atomicra1n/desk-annunciator-panel/images/labels.png

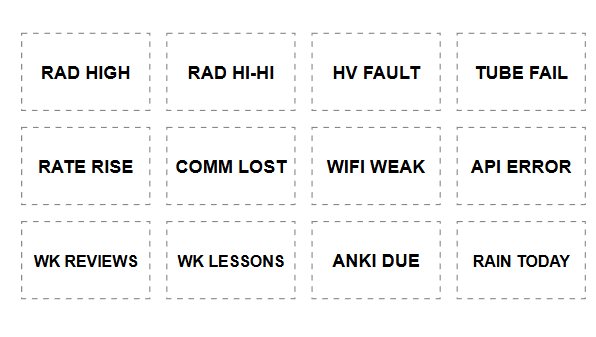
images/labels.png
