atomicra1n/desk-annunciator-panel/images/pcb.png

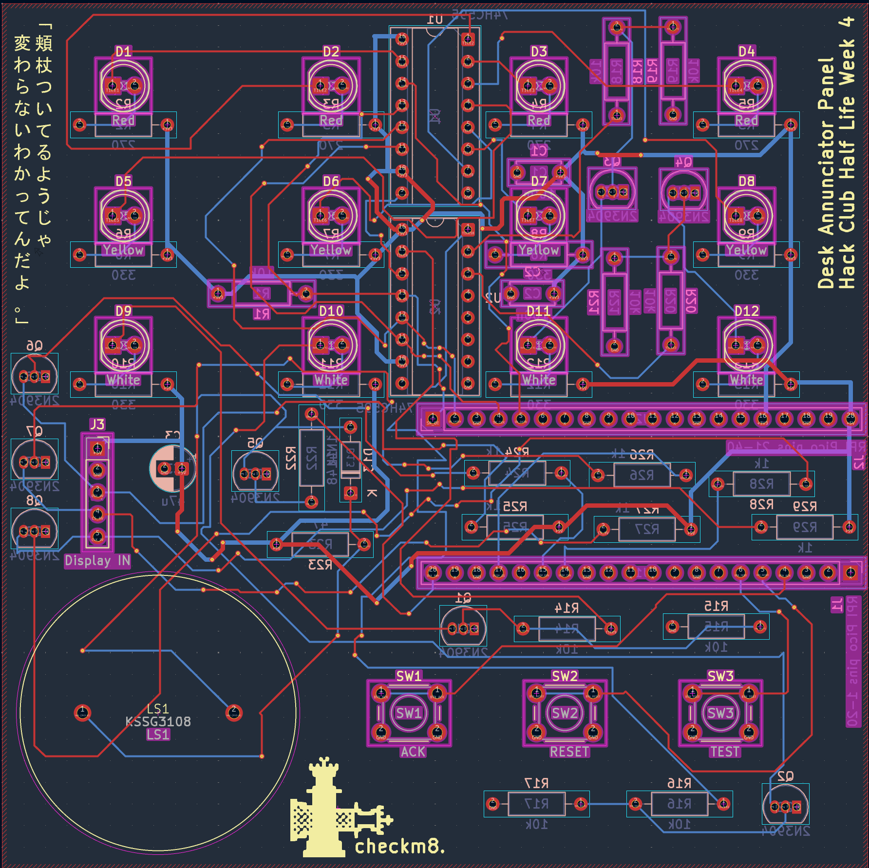
images/pcb.png
