atomicra1n/desk-annunciator-panel/images/pcb_back.png

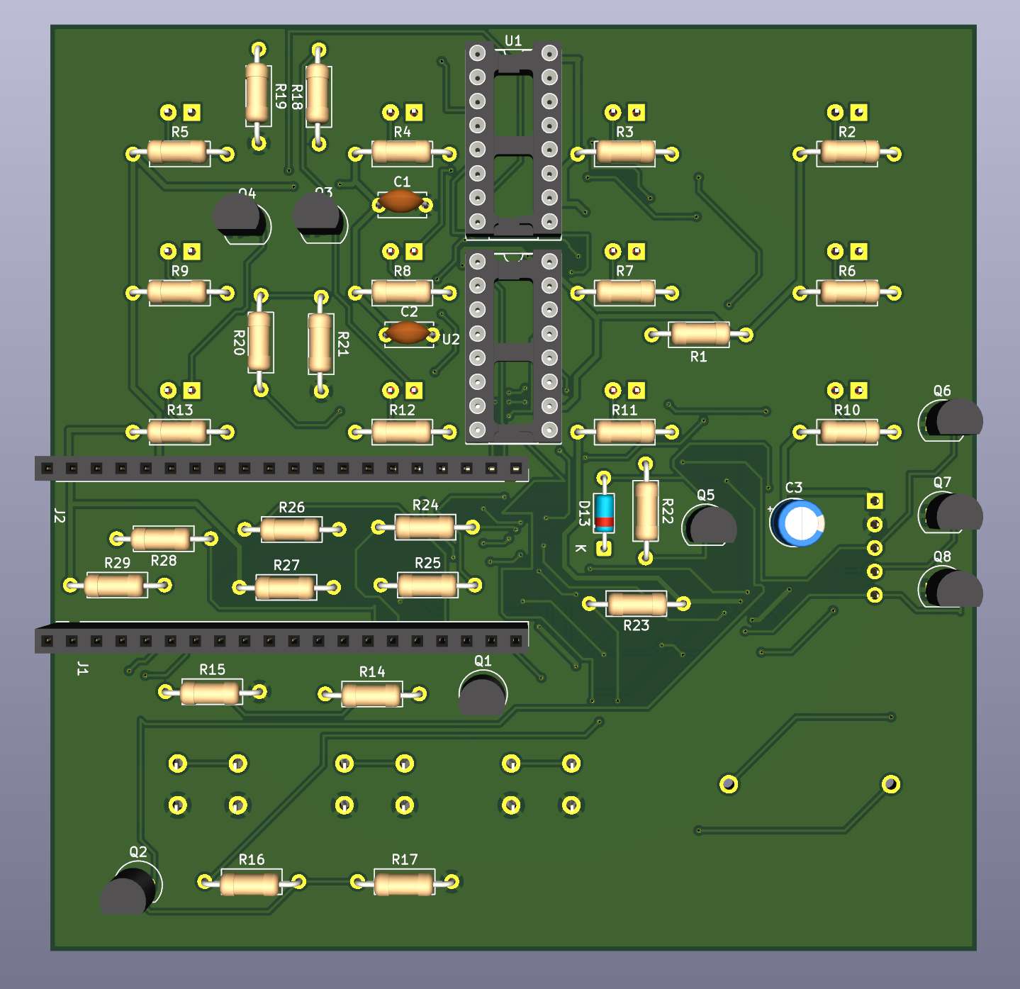
images/pcb_back.png
