atomicra1n/desk-annunciator-panel/images/pcb_front.png

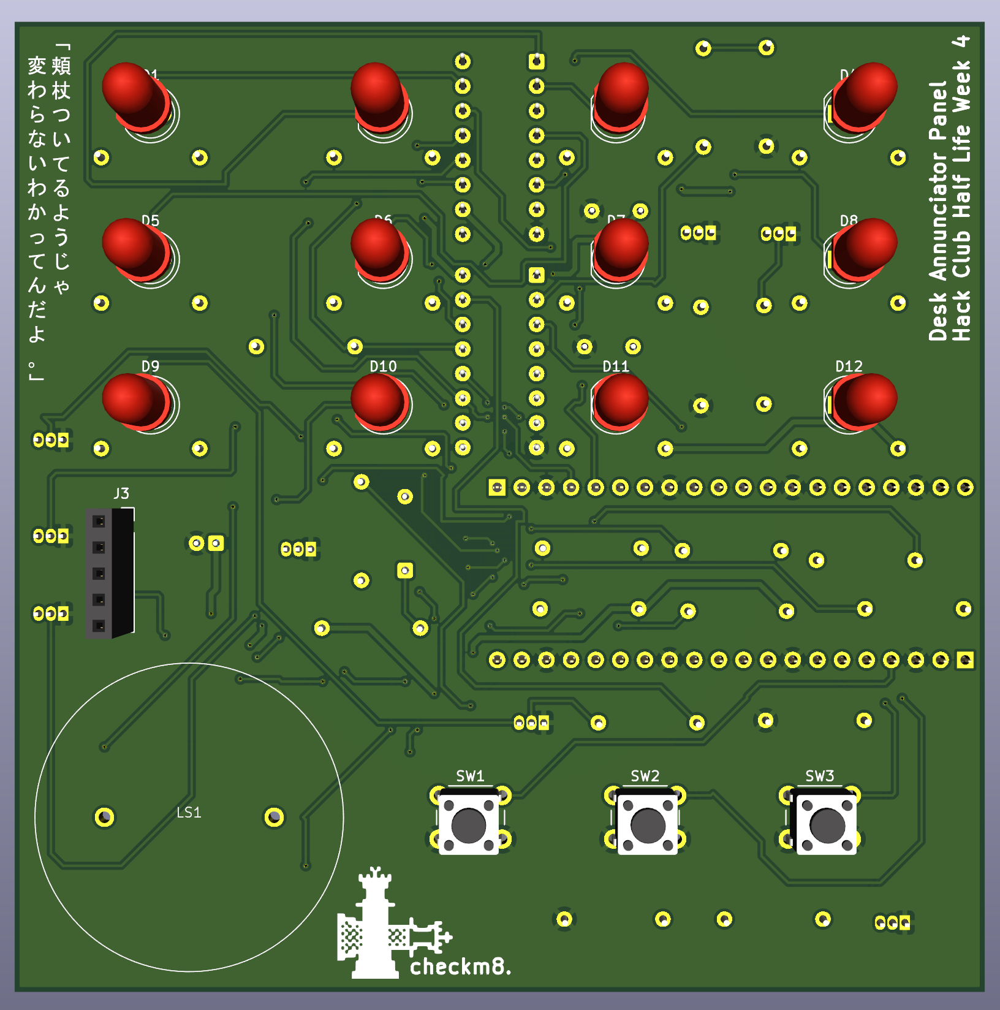
images/pcb_front.png
