atomicra1n/desk-annunciator-panel/images/render.png

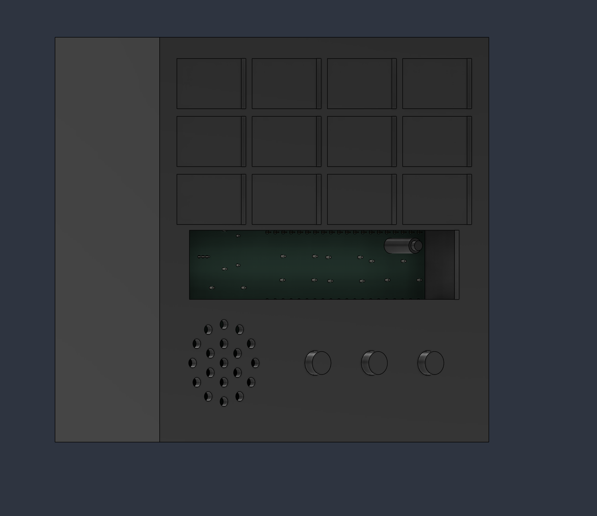
images/render.png
