atomicra1n/desk-annunciator-panel/images/schematic.png

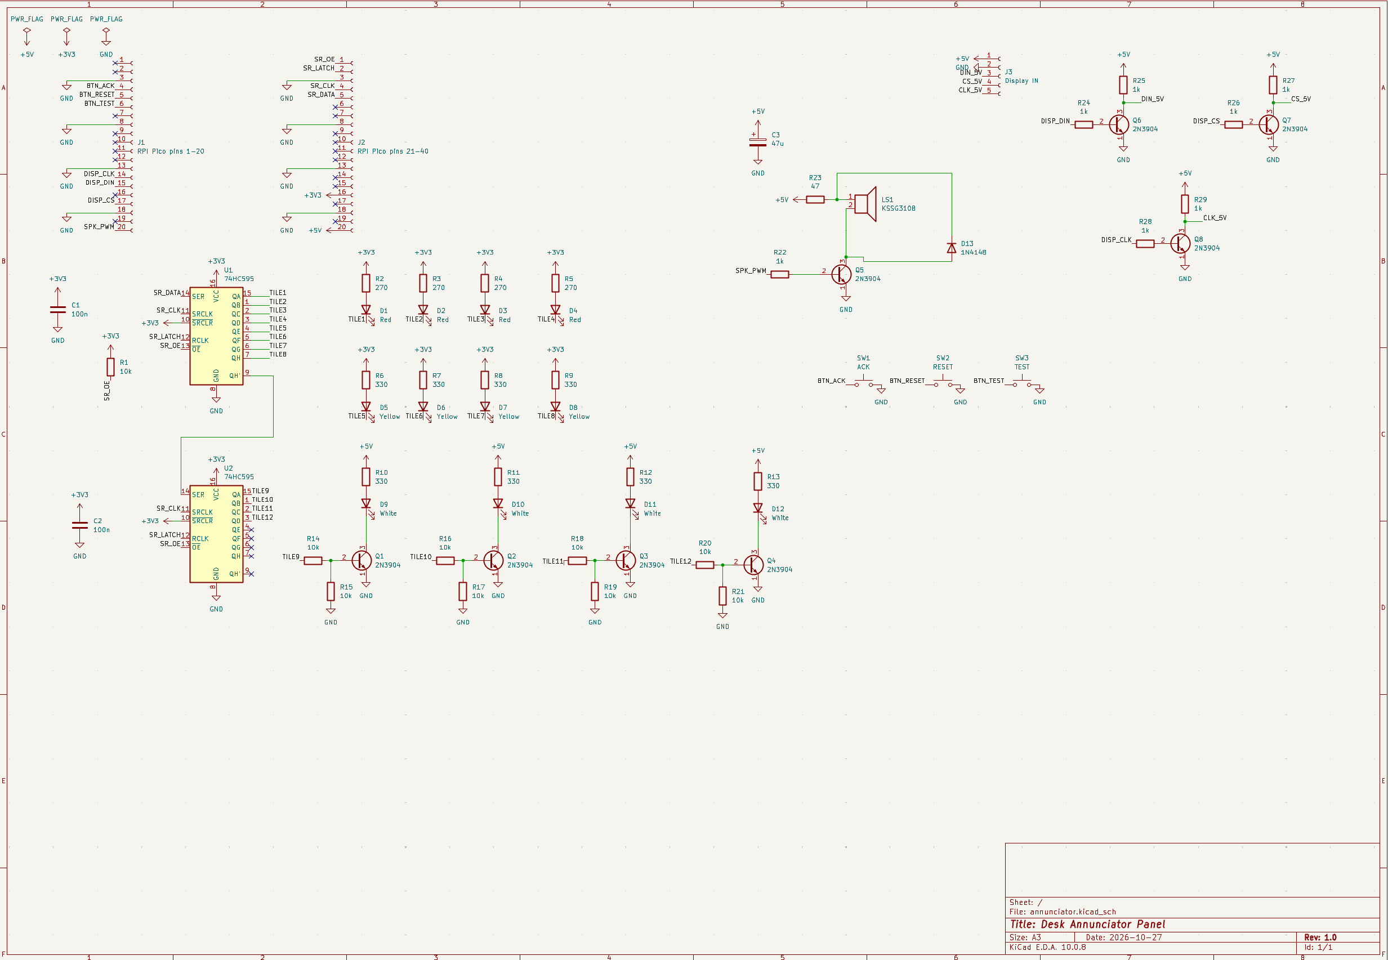
images/schematic.png
