atomicra1n/desk-annunciator-panel/cad/desk-annunciator-enclosure.step

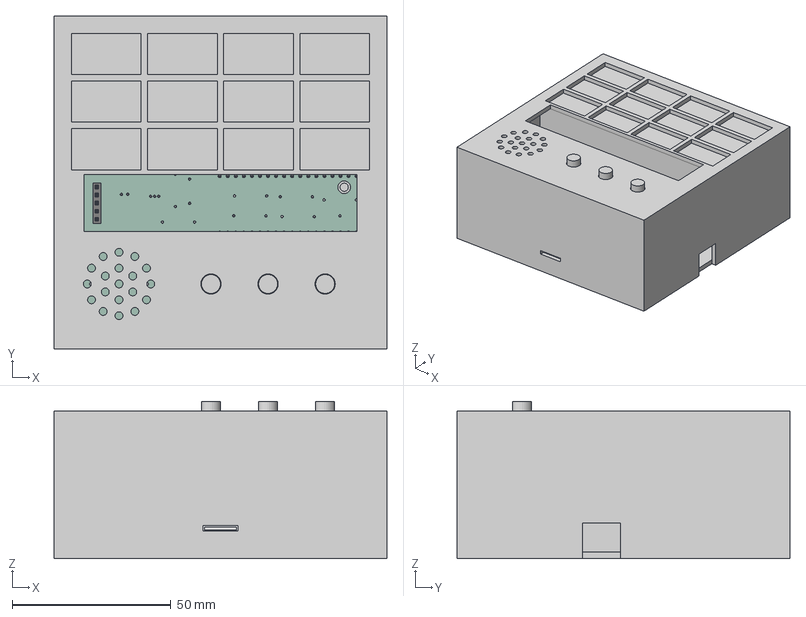
[picture p7: CAD file, 2026-10-31]
cad/desk-annunciator-enclosure.step
105.0 x 105.0 x 49.5 mm
ann4A88_PCB
LED_D5.0mm_1 x 12
SW_PUSH_6mm_1 x 3
PinSocket_1x05_P2.54mm_Vertical_1
TO-92_Inline_Narrow x 8
PinSocket_1x20_P2.54mm_Vertical_1 x 2
CP_Radial_D50mm_P200mm
R_Axial_DIN0207_L63mm_D25mm_P1016mm_Horizontal x 29
DIP_16_W762mm_Socket x 2
C_Disc_D50mm_W25mm_P500mm x 2
D_DO-35_SOD27_P7.62mm_Horizontal_1
