atomicra1n/desk-annunciator-panel/pcb/annunciator.step

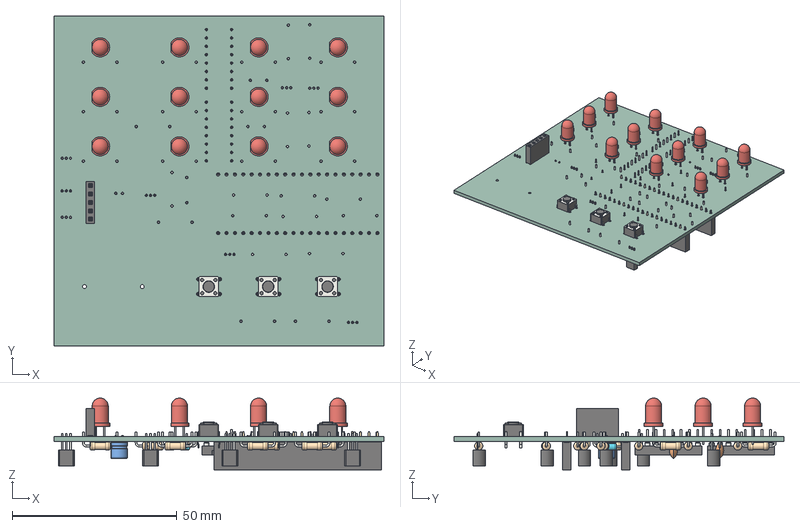
[picture p8: CAD file, 2026-10-29]
pcb/annunciator.step
100.0 x 100.0 x 21.8 mm
SW_PUSH_6mm x 3
PinSocket_1x05_P2.54mm_Vertical
LED_D5.0mm x 12
TO-92_Inline_Narrow x 8
R_Axial_DIN0207_L63mm_D25mm_P1016mm_Horizontal x 29
DIP_16_W762mm_Socket x 2
PinSocket_1x20_P2.54mm_Vertical x 2
CP_Radial_D50mm_P200mm
C_Disc_D50mm_W25mm_P500mm x 2
D_DO-35_SOD27_P7.62mm_Horizontal
ann4A88_PCB
