atomicra1n/desk-annunciator-panel/stl/display_support.stl

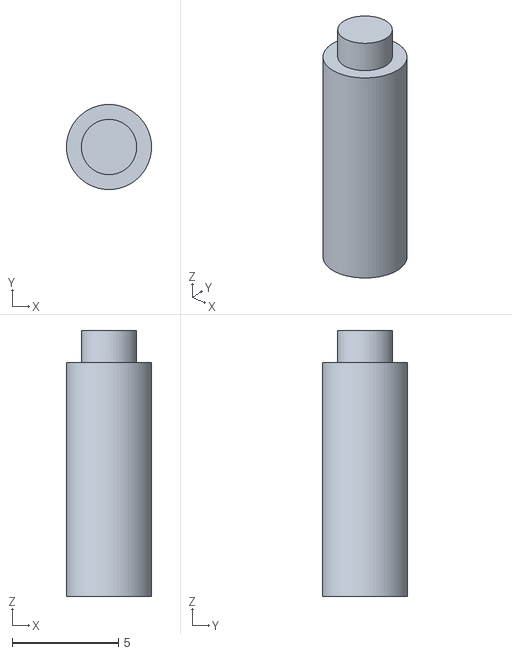
[picture p9: CAD file, 2026-10-30]
stl/display_support.stl
4.00 x 4.00 x 12.5
