atomicra1n/desk-annunciator-panel/stl/back_cover.stl

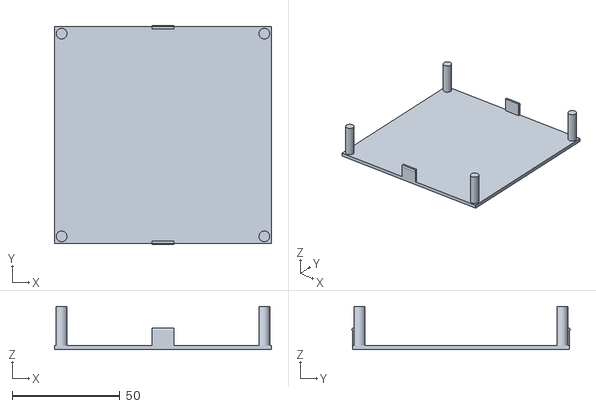
[picture p10: CAD file, 2026-10-30]
stl/back_cover.stl
100.6 x 101.6 x 20.0
