atomicra1n/desk-annunciator-panel/stl/diffusers.stl

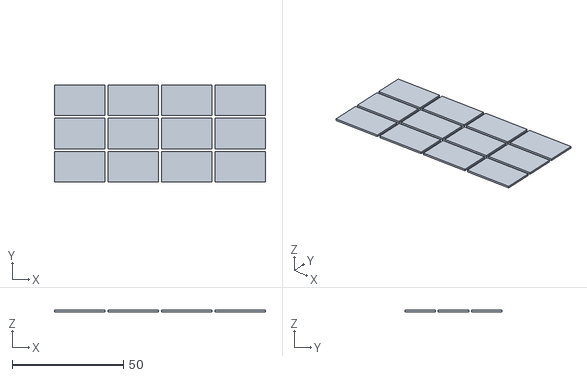
[picture p11: CAD file, 2026-10-30]
stl/diffusers.stl
94.7 x 43.7 x 0.8
