atomicra1n/desk-annunciator-panel/stl/plungers.stl

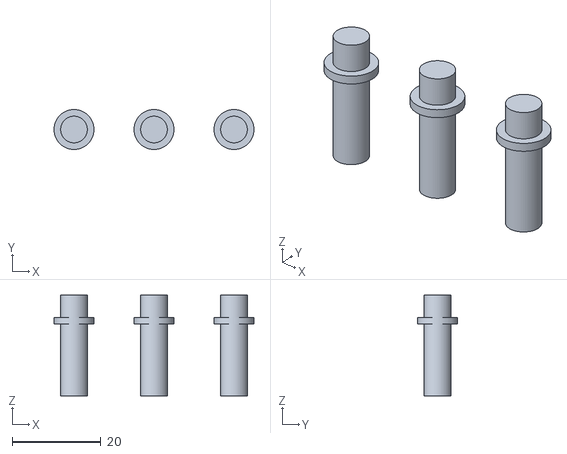
[picture p12: CAD file, 2026-10-30]
stl/plungers.stl
45.0 x 8.99 x 22.7
