atomicra1n/desk-annunciator-panel/stl/bezel.stl

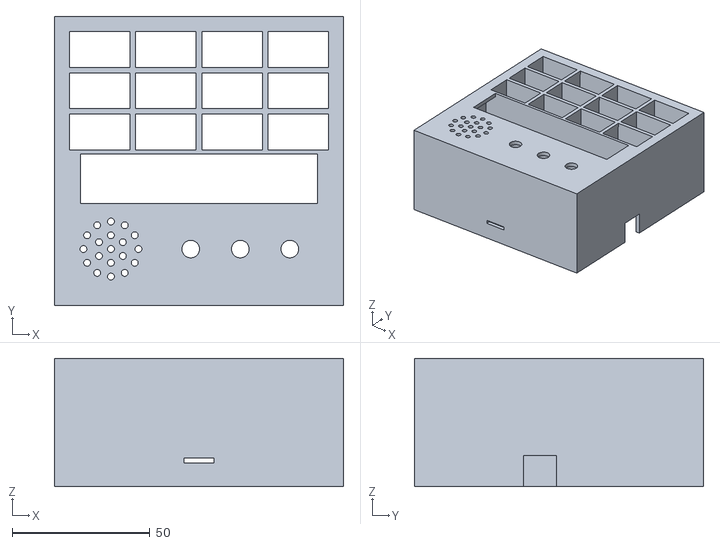
[picture p13: CAD file, 2026-10-30]
stl/bezel.stl
105.0 x 105.0 x 46.5
