atomicra1n/desk-annunciator-panel/(list of files, cad)

Other CAD files:
cad/desk-annunciator-enclosure.f3d
