atomicra1n/desk-annunciator-panel/JOURNAL.md

# Desk Annunciator Panel: devlog

<!-- Generated by Half Life from project ja1c03rl5tihal0xsxyik3il. Edits here are overwritten on the next sync. -->
<!-- Generated: 2026-10-31T18:48:24.872Z -->

> [!NOTE]
> This devlog is mirrored from [Half Life](https://halflife.hackclub.com) ([open the project](https://halflife.hackclub.com/projects/ja1c03rl5tihal0xsxyik3il)). Editing it here will not change the platform's copy, and the next sync overwrites this file.

> A small nuclear power plant MCR-inspired annunciator panel with backlit alarm tiles and a 7 segment display showing live radiation data from my Geiger Counter and status of my homelab.

| Week | Tier | Hours logged | Entries |
| --- | --- | --- | --- |
| Week 4 | Tier 1 | 25h | 5 |

## Contents

1. [2026-10-27: # Oct 27: Parts, KiCad project and first schematic progress](#2026-10-27-oct-27-parts-kicad-project-and-first-schematic-pr)
2. [2026-10-28: # Oct 28: Tackling issues from yesterday, finished schematic and started PCB](#2026-10-28-oct-28-tackling-issues-from-yesterday-finished-sc)
3. [2026-10-29: # Oct 29: Fixing issues, finishing routing, exporting gerbers and CAD work](#2026-10-29-oct-29-fixing-issues-finishing-routing-exporting-)
4. [2026-10-30: # Oct 30: CAD work and firmware](#2026-10-30-oct-30-cad-work-and-firmware)
5. [2026-10-31: # Oct 31: Firmware and finalization](#2026-10-31-oct-31-firmware-and-finalization)

## Design

### 2026-10-27: # Oct 27: Parts, KiCad project and first schematic progress

**3h**

# Oct 27: Parts, KiCad project and first schematic progress

This week's theme is displays, so I wanted to further dwell into my nuclear energy interest (see my week 1 Geiger project!) and make something related. One of the coolest parts of any Nuclear Power Plant is obviously the Main Control Room, and it is full of annunciators. Walls of backlit tiles, and when something goes wrong, one of the tiles flashes and sounds an alarm until it is handled by the operator. So why not make it desk sized?

I've played a lot of nuclear related simulations, and I know roughly how they work. When a transient or other incident occurs, the relevant alarms start flashing fast. The operator can then press an ACK button to change the flashing to a steady state. After the condition is cleared (say your pressure was high and now it's okay), the tile flashes slowly until RESET is pressed. And there's our firmware! But that's work for later, we have the schematic to tackle first.

For the display side, I went with 12 backlit tiles, each with 5mm LEDs behind a 3d printed diffuser and a [seven segment display](https://www.gme.cz/v/1508913/led-displej-8x7-segmentu-cerveny) for CPM and uSv/h readings from my Geiger (yes, I'll try to connect them to add a high radiation alarm). The LEDs will be driven by two [shift registers](https://www.gme.cz/74hc595-dip16-texas-instruments) and it will all be controlled by a RPi Pico W, which I already have at home, so I can spare some money from the BOM!

Picking out first parts

When picking out the shift register, I originally wanted the 74HCT595 so that the chip could run at 5V and still be driven by 3.3V logic from the RPI, but sadly GM Electronic (my local electronics retailer) only had the HC variant and the HCT was available only as SMD, which I did not dare come close to after my Geiger project design (zero clue how I'm gonna solder that one..).

The HC version of the shift register needs logic inputs close to VCC, which means the entire chip has to run at 3.3V if we are using the RPi Pico. My red and yellow LEDs only need 2V forward voltage, so that's fine, but the white LEDs needed around 2.9V, which is too close and leaves almost no headroom.

I tried a few solutions (smaller resistor to let more current in?), but ended up connecting the anodes of the white LEDs to 5V instead of 3.3V. This means that when the shift register sets output to high, the voltage across the LED is only 1.7V and it shouldn't turn on. In the opposite scenario, when the output goes low, the LEDs should have no issue turning on.

In KiCad, I was able to tackle a good part of the schematic, mostly the pins of the Pico (ended up using 2x 1x20 socket connectors in place of the Pico as there wasn't a proper symbol for it I could find). I used the [Pico's datasheet](https://pip-assets.raspberrypi.com/categories/686-raspberry-pi-pico-w/documents/RP-008312-DS-2-pico-w-datasheet.pdf) to assign pins, and ended up assigning pins for the shift registers, the display and for the ACK/RESET/TEST buttons (test will light up all annunciators at once). I made a few mistakes and assigned to the wrong pins a few times, but checked my work and fixed it before it became an issue.

Raspberry pi pico pins

I also setup the two shift registers, chained them together, added a pull up resistor to make sure LEDs don't flash during boot and made the chain of 12 LEDs (the actual annunciator panels!). They were similar, but the resistor values and colors of the LEDs were different in each.

Shift registers and LEDs

**tl;dr:** Sorted out parts for the project and established the concept and setup the pins for the Pico, handled shift registers (sorting out a voltage problem along the way) and made the LED chain.

**Time spent: ~3 hours**

**Next up:** Finishing the schematic.

### 2026-10-28: # Oct 28: Tackling issues from yesterday, finished schematic and started PCB

**6h**

# Oct 28: Tackling issues from yesterday, finished schematic and started PCB

I started today by fixing an issue I noticed from yesterday. In my schematic the white LEDs have their anodes on 5V, however, the shift register runs at 3.3 volts. I looked at the datasheet of the [74HC595](https://www.ti.com/lit/ds/symlink/sn74hc595.pdf) and it says that the voltage on any output pin must not go more than 0.5V above the VCC, yet we have a 1.7V difference on the 5V side.

To fix this, I added a transistor between each white LED and shift register. The output of the shift register now only drives the base of the transistor through a 10 kiloohm resistor, so the output pin never encounters the 5 volts we had before. I also added another 10k resistor pulling the base to ground to ensure it stays off during boot. However, we need to be careful when we make the firmware, as it means the white LED row now has inverted logic compared to red and yellow, and HIGH means on.

Revised white LEDs

After this fix, I finished the rest of the schematic, mainly the MAX7219 display module which connects through a 5 pin socket. Originally I planned to have a second socket to support the other end of the module, but encountered an issue where I don't know the exact size of the module. Some manufacturers list it as 80mm, some list 85mm, so I would have to guess. Instead, I completely removed the second socket and decided I will sit the other end on a 3D printed support bracket.

The speaker circuit has a 2N3904 transistor switching my KSSG3108 speaker via a 47 ohm resistor. This way we stay within its 0.1W rating. I also had to make a custom footprint from the datasheet for it, as it isn't a standard part in KiCad.

Speaker, display and button section

Finished schematic

I added the three buttons (ACK, RESET and TEST) which was quite simple and then moved onto assigning footprints for the PCB. This was a bit trickier. As with every other project I've done so far, the auto suggestions from KiCad were wrong. I had to fix each one manually.

Incorrect footprint suggestions from KiCad

Finished footprint assignments

Custom speaker footprint

Then I started the PCB layout. I quickly realized everything wouldn't fit on one side of a 100x100mm board, so I decided I would place the 12 LEDs on the front and keep most electronics on the back side. This was a bit new to me, as all previous projects used previously only used one side of the PCB for components. The placement of the back side isn't the prettiest, but it should work.

I also setup design rules to define clearance and track size, and began some routing. I routed each LED to its resistor and did most of the routing from the TILE lines on each LED to the shift registers, which was a bit tricky on the white LEDs as they also have the transistor. So far, the design rules checker didn't notice any issues.

Configured design rules

Component placement and routing progress

Front side 3D Render so far

Back side 3D Render so far

**tl;dr: Fixed an issue with the white LED voltage, finished the schematic, made a custom footprint for the speaker, assigned footprints, placed all parts on the PCB and began routing.**

**Total time spent: ~6 hours**

**Next up: Finishing routing, ground pour**

### 2026-10-29: # Oct 29: Fixing issues, finishing routing, exporting gerbers and CAD work

**6h**

# Oct 29: Fixing issues, finishing routing, exporting gerbers and CAD work

The first thing I did today was fix another issue from yesterday. I looked at the datasheet of the seven segment display I'm using ([MAX7219](https://www.analog.com/media/en/technical-documentation/data-sheets/MAX7219-MAX7221.pdf)) and it turns out that it needs 3.5 volts for a HIGH input, yet our RPI Pico only outputs 3.3 volts. I decided I would build a small level shifter from some extra parts I had in my GM cart (I had some extra transistors and resistors due to minimum order quantities). I used three 2N3904 transistors each with a 1k resistor on the base and another pullup to 5 volts on the collector.

Again a similar issue as with the white LEDs occurs here that each transistor will invert the signal, meaning the display will see a LOW when the Pico sends a HIGH. Thankfully it should just be a few lines of code in the firmware so no big deal.

Level shifter in my schematic

After that I added the shifter components to the PCB and continued routing. This took arguably the longest as there was A LOT of components that were really cramped, but I managed to route it and get rid of all the ratslines. After finishing the routing, I did the ground pour to connect all the GND pads and ran DRC. For the first time while working on Half Life, I got a clean DRC after a ground pour! This made me very happy, usually I had some unconnected islands or spots the pour couldn't reach but it was perfect today.

Routed board

Ground pour

Clean DRC

Afterwards, I exported Gerbers and checked JLCPCB for a quote. Just like my other projects, the 100x100 board 5x came out to around 15$ with shipping, which was roughly what I expected. There are also some coupons available but I'm not sure if they will still be available when I'm ordering the board or whether they won't be used up on  my other orders.

PCB quote

With all KiCad work done, I also exported a STEP file and imported it to Autodesk Fusion to work on the enclosure. I made a 105 milimeter by 105 milimeter box. Then I cut 12 windows for each annunciator pane and a window for the seven segment displays. I also made a second grid with each cell slightly larger than the inner window and extruded it down to stop 3 milimeters above the PCB. I originally tried 2 milimeters, but Fusion's interference checker found issues, so I shortened it a bit.

Imported PCB in Fusion

Interference

Today's CAD progress

**tl;dr: Built level shifters using transistors for the seven segment display, finished all routing, did the ground pour, exported Gerbers, got a JLCPCB quote, started Fusion enclosure work with the shell, tile and display windows and extruded grid.**

**Time spent: ~6 hours**

**Next up: Finishing the enclosure and CAD work**

### 2026-10-30: # Oct 30: CAD work and firmware

**6h**

# Oct 30: CAD work and firmware

Most of today's work happened in Autodesk Fusion where I finished designing the enclosure for 3D printing. Yesterday I only made the basic shell with windows for the tiles and display but today I finished it so it can actually be assembled.

First I worked on the buttons, I added a plunger above each button on the PCB that reaches through the front plate, it is a 6 milimeter rod with a slightly bigger flange making sure it doesn't fall out. I made the rod 0.4 milimeters smaller than the hole and had to be a bit careful about dimensions to make sure it doesn't bind nor wobble.

Button plunger design

I then made the speaker grill, which was just a circular pattern of holes in the front plate. I made one center hole and two rings, one with 6 holes and the other with 12 holes which came out to 19 holes total. Next, I had to tackle handling the 7 segment display module. It plugs in only on one end into J3, so I need to hold it up with something on the other end. I made a small extruded circle with a pin on top of it which will go into the seven segment display module's mounting hole (in the corner). It's a separate part so if the hole ends up in a different spot I can adjust and reprint it. I was originally going to design the PCB so it would hold the display, but each store I looked at listed slightly different specs or dimensions for the display and if I went with the wrong one, it wouldn't work properly after my PCB was assembled. This way, in the worst case scenario, I can easily adjust.

Speaker grill

Display holding pin

Then I made the diffuser tiles. I made 12 tiles each sitting in one of the windows. They will be printed in white PLA to let the LED light through, and the label paper will be placed on them.

Diffusers

The hardest part was deciding how I would hold the PCB inside the enclosure. In the end, I made 4 small ledges on the inside of the bezel walls that I will rest the PCB against, and made a back cover with 4 posts in the corners (extruded circles) that press against the board. The back cover has two small flexible arms with small hooks that click into slots that I cut through the enclosure. I wanted to avoid screws to reduce my BOM a little. I ran Fusion's interference and it only found some interference on the PCB but that's likely from the KiCad export itself from the components and doesn't really matter to me. Lastly, I made the cutout for the USB port of the RPI Pico.

Ledges and posts

USB port cutout

Final enclosure model

I continued today's work by making the printable label sheets for each of the tiles and started work on the firmware. I made a small test in CircuitPython. The shift registers use SPI to send 16 bits (the first 8 tiles on U1 and the remaining 4 ones on U2). It took me a while to figure out the white tiles because due to my changes from 1 or 2 days ago, their logic is inverted so we need to flip it in the code as well. For the yellow and red rows, setting the bit to 0 turns it on and 1 turns it off, whereas for the white ones it works the exact opposite. I made it so we check if the tile index is 8 or more and flip the logic if so. My test lights each tile one by one and has a loop which lets the user toggle the lights with the buttons, which isn't the intended functionality yet, but I wanted to mostly get an idea of how the lighting will work in CircuitPython so I made a small demo. I will build on top of it tomorrow. While working on this journal entry, I actually noticed that my firmware already had a bug, and the inverter logic was opposite! I inverted the inverter logic, that's quite the problem. Anyway, I fixed it and committed it, I just had to swap the two branches.

Basic firmware test

**tl;dr: Finished all CAD work (entire enclosure with button plungers, speaker grill, display supports, diffuser tiles, back cover and USB cutout), created labels and made the initial test for the firmware.**

**Time spent: ~6 hours**

**Next up: Finishing the firmware and project completion**

### 2026-10-31: # Oct 31: Firmware and finalization

**4h**

# Oct 31: Firmware and finalization

Today I mostly worked on getting the firmware to a proper state. Yesterday I only had a basic test for the LEDs and buttons but I needed the actual logic for alarms and connectivity.

Firstly I worked on the alarm state machine, I put the shift register logic into a separate file (tiles.py) and added alarm states. Each tile can be OFF, FLASH (new alarm blinking fast), STEADY (ACKed and solid on) or RING (condition cleared, slow blinking pending RESET). This esentially follows the sequence of how annunciators work in a real NPP MCP. It was a bit tricky to get the timing right for the two flash rates, I used time.monotonic() to decide when to toggle each one but it might cause some drift over time, I will see how it looks in build week and perhaps improve the logic if needed.

States logic

Now I needed to get the seven segment display and make it work. This was probably the hardest, the MAX7219 is on a different GPIO pin than the shift register, so I couldn't reuse the same SPI bus. The biggest source of confusion were the transistor level shifters, because they invert each signal. If I want a HIGH on the MAX7219, I need to output a LOW. The display uses the BCD decode mode so I send digit values and it handles the segments. I wrote a function to show the CPM and microsievert readings. The decimal point handling is also a bit clumsy as I walk the string character by character and if I find a dot I re-send the last digit with the dot flag set. It's quite a bandaid solution but it's the best one I thought of that should work.

Display logic and readings

The last part was Wi-Fi and sourcing the data. The RPi Pico WH connects to Wi-Fi using the wifi module built into CircuitPython and queries the Geiger API every 5 seconds. I check the current CPM, uSv/h, HV and total counts against configured values to decide whether to enable alarms. If the high voltage circuit drops below 350V, I light up HV fault. For tube failure, I check if the total count hasn't changed for 30 seconds, which is also a bit of a bandaid solution but there isn't really a more definite way to check it. Background radiation should keep increaasing it but if not I might increase the threshold during build week. I also added rain checking using the free Open-Meteo API and since I learn Japanese and use various services to practice (WaniKani, Anki...), I added annunciator tiles for them and I made the basic logic for them but haven't yet connected them to an API. I will likely need a Cloudflare Worker as a middleman, so I will do that during build week as it's hard to test now. However, there's also a demo mode which cycles fake alarms automatically and it can be shown off even without Wi-Fi!

Alarm triggering logic

The sounds are simple PWM beeps for now. Eventually I might switch to proper WAV playback but it would likely introduce new libraries and I didn't want to overcomplicate. After finishing the firmware, I finished the final BOM and README and got ready for submission!

Simple sound logic

**tl;dr: Built the alarm state logic, MAX7219 display handling, Wi-Fi connectivity to the Geiger counter API, rain checks, a demo mode and finalized the README and BOM.**

**Time spent: ~4 hours**
