atomicra1n/desk-annunciator-panel/pcb/annunciator.kicad_pcb

## KiCad design pcb/annunciator.kicad_pcb (2026-10-29)

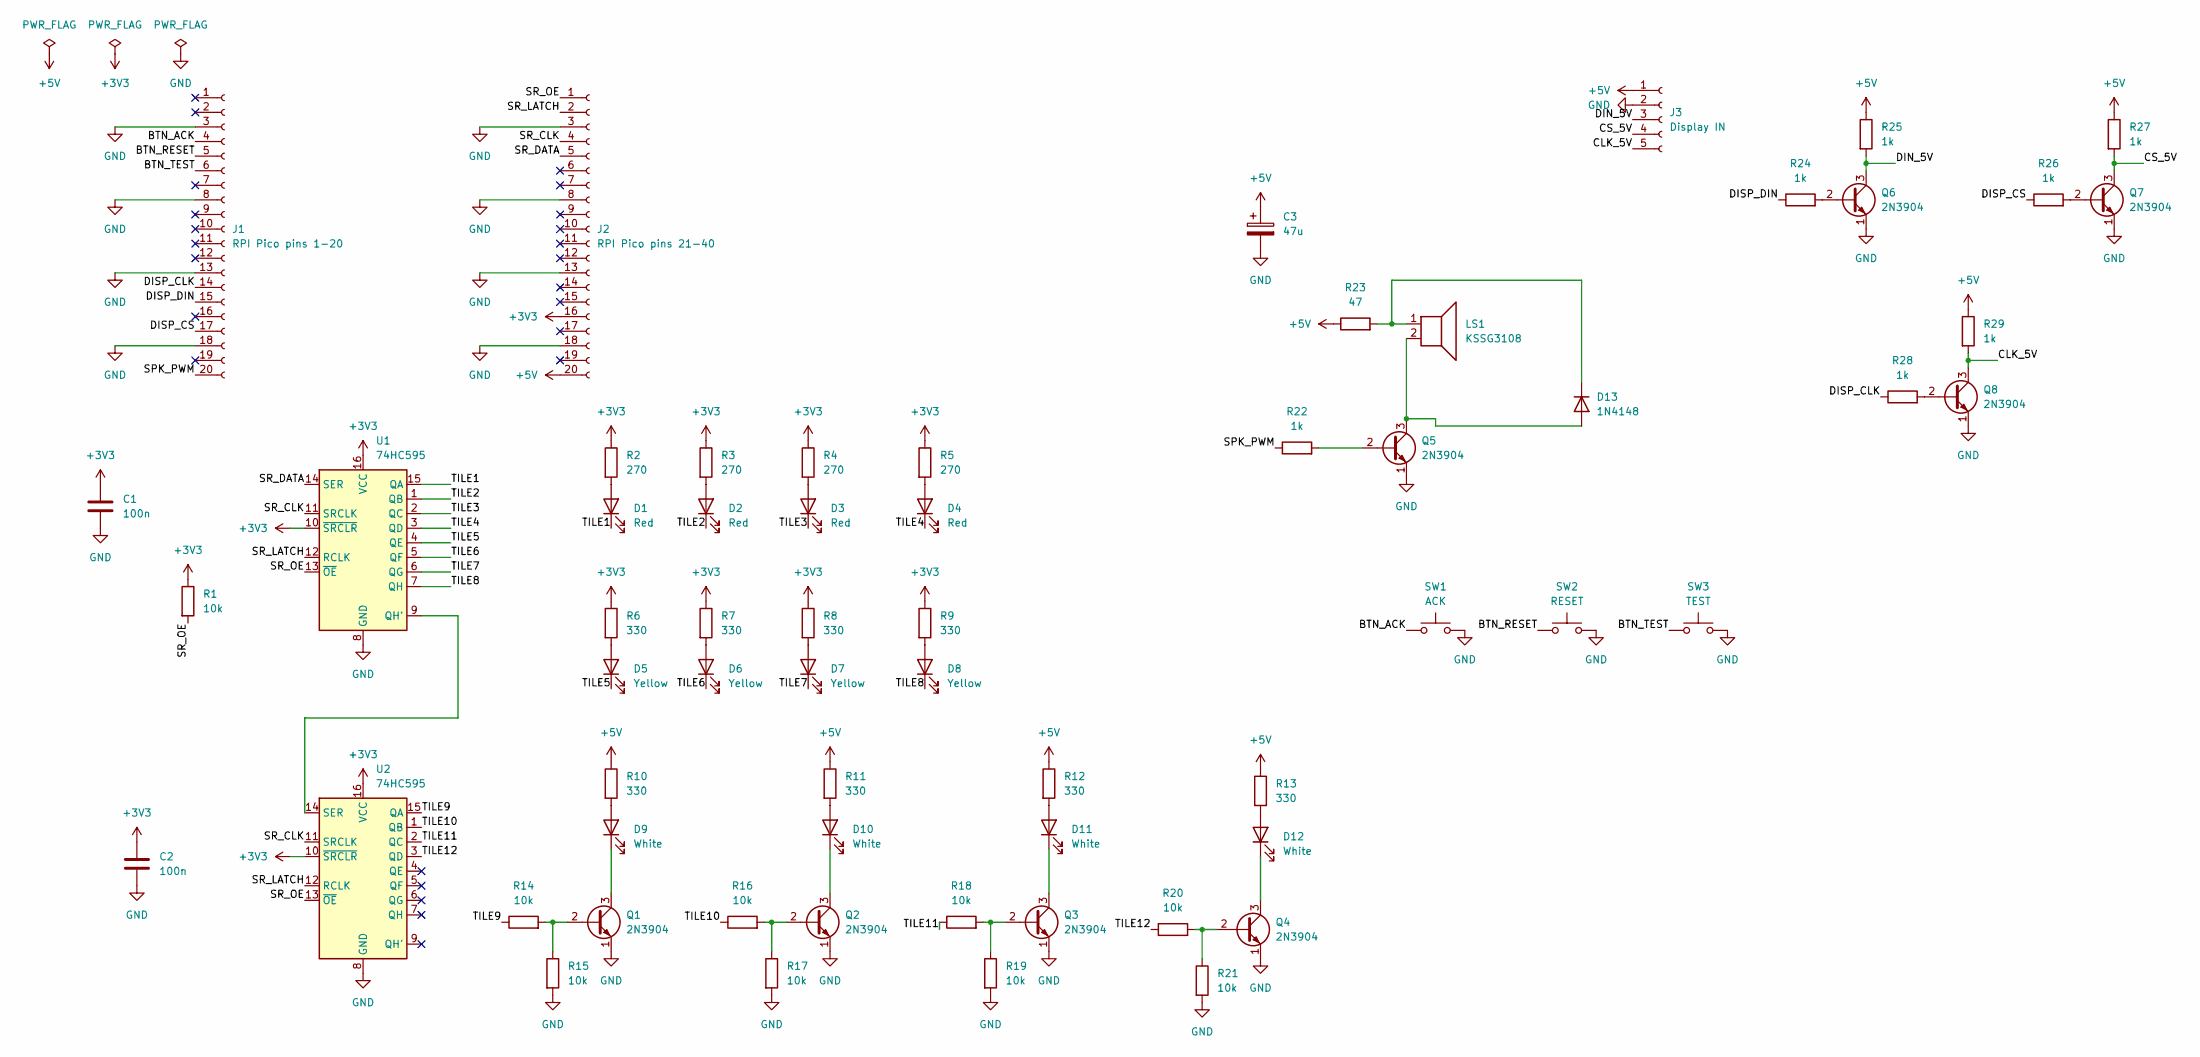
[picture p14: schematic annunciator.kicad_sch, Desk Annunciator Panel]

Parts:
C1, C2: 100n; C_Disc_D5.0mm_W2.5mm_P5.00mm
C3: 47u; CP_Radial_D5.0mm_P2.00mm
D1, D2, D3, D4: Red; LED_D5.0mm
D5, D6, D7, D8: Yellow; LED_D5.0mm
D9, D10, D11, D12: White; LED_D5.0mm
D13: 1N4148; D_DO-35_SOD27_P7.62mm_Horizontal
J1: RPI Pico pins 1-20; PinSocket_1x20_P2.54mm_Vertical
J2: RPI Pico pins 21-40; PinSocket_1x20_P2.54mm_Vertical
J3: Display IN; PinSocket_1x05_P2.54mm_Vertical
LS1: KSSG3108
Q1, Q2, Q3, Q4, Q5, Q6, Q7, Q8: 2N3904; TO-92_Inline
R1, R14, R15, R16, R17, R18, R19, R20, R21: 10k; R_Axial_DIN0207_L6.3mm_D2.5mm_P10.16mm_Horizontal
R2, R3, R4, R5: 270; R_Axial_DIN0207_L6.3mm_D2.5mm_P10.16mm_Horizontal
R6, R7, R8, R9, R10, R11, R12, R13: 330; R_Axial_DIN0207_L6.3mm_D2.5mm_P10.16mm_Horizontal
R22, R24, R25, R26, R27, R28, R29: 1k; R_Axial_DIN0207_L6.3mm_D2.5mm_P10.16mm_Horizontal
R23: 47; R_Axial_DIN0207_L6.3mm_D2.5mm_P10.16mm_Horizontal
SW1: ACK; SW_PUSH_6mm
SW2: RESET; SW_PUSH_6mm
SW3: TEST; SW_PUSH_6mm
U1, U2: 74HC595; DIP-16_W7.62mm_Socket

Connections:
+3V3: C1.1, C2.1, J2.16, R1.1, R2.1, R3.1, R4.1, R5.1, R6.1, R7.1, R8.1, R9.1, U1.10 (~SRCLR), U1.16 (VCC), U2.10 (~SRCLR), U2.16 (VCC)
+5V: C3.1, J2.20, J3.1, R10.1, R11.1, R12.1, R13.1, R23.1, R25.1, R27.1, R29.1
/BTN_ACK: J1.4, SW1.1
/BTN_RESET: J1.5, SW2.1
/BTN_TEST: J1.6, SW3.1
/CLK_5V: J3.5, Q8.3 (C), R29.2
/CS_5V: J3.4, Q7.3 (C), R27.2
/DIN_5V: J3.3, Q6.3 (C), R25.2
/DISP_CLK: J1.14, R28.1
/DISP_CS: J1.17, R26.1
/DISP_DIN: J1.15, R24.1
/SPK_PWM: J1.20, R22.1
/SR_CLK: J2.4, U1.11 (SRCLK), U2.11 (SRCLK)
/SR_DATA: J2.5, U1.14 (SER)
/SR_LATCH: J2.2, U1.12 (RCLK), U2.12 (RCLK)
/SR_OE: J2.1, R1.2, U1.13 (~OE), U2.13 (~OE)
/TILE1: D1.1 (K), U1.15 (QA)
/TILE2: D2.1 (K), U1.1 (QB)
/TILE3: D3.1 (K), U1.2 (QC)
/TILE4: D4.1 (K), U1.3 (QD)
/TILE5: D5.1 (K), U1.4 (QE)
/TILE6: D6.1 (K), U1.5 (QF)
/TILE7: D7.1 (K), U1.6 (QG)
/TILE8: D8.1 (K), U1.7 (QH)
/TILE9: R14.1, U2.15 (QA)
/TILE10: R16.1, U2.1 (QB)
/TILE11: R18.1, U2.2 (QC)
/TILE12: R20.1, U2.3 (QD)
GND: C1.2, C2.2, C3.2, J1.3, J1.8, J1.13, J1.18, J2.3, J2.8, J2.13, J2.18, J3.2, Q1.1 (E), Q2.1 (E), Q3.1 (E), Q4.1 (E), Q5.1 (E), Q6.1 (E), Q7.1 (E), Q8.1 (E), R15.2, R17.2, R19.2, R21.2, SW1.2, SW2.2, SW3.2, U1.8 (GND), U2.8 (GND)
unnamed: D1.2 (A), R2.2
unnamed: D2.2 (A), R3.2
unnamed: D3.2 (A), R4.2
unnamed: D4.2 (A), R5.2
unnamed: D5.2 (A), R6.2
unnamed: D6.2 (A), R7.2
unnamed: D7.2 (A), R8.2
unnamed: D8.2 (A), R9.2
unnamed: D9.2 (A), R10.2
unnamed: D9.1 (K), Q1.3 (C)
unnamed: D10.2 (A), R11.2
unnamed: D10.1 (K), Q2.3 (C)
unnamed: D11.2 (A), R12.2
unnamed: D11.1 (K), Q3.3 (C)
unnamed: D12.2 (A), R13.2
unnamed: D12.1 (K), Q4.3 (C)
unnamed: D13.2 (A), LS1.2, Q5.3 (C)
unnamed: D13.1 (K), LS1.1, R23.2
unnamed: Q1.2 (B), R14.2, R15.1
unnamed: Q2.2 (B), R16.2, R17.1
unnamed: Q3.2 (B), R18.2, R19.1
unnamed: Q4.2 (B), R20.2, R21.1
unnamed: Q5.2 (B), R22.2
unnamed: Q6.2 (B), R24.2
unnamed: Q7.2 (B), R26.2
unnamed: Q8.2 (B), R28.2
unnamed: U1.9 (QH'), U2.14 (SER)

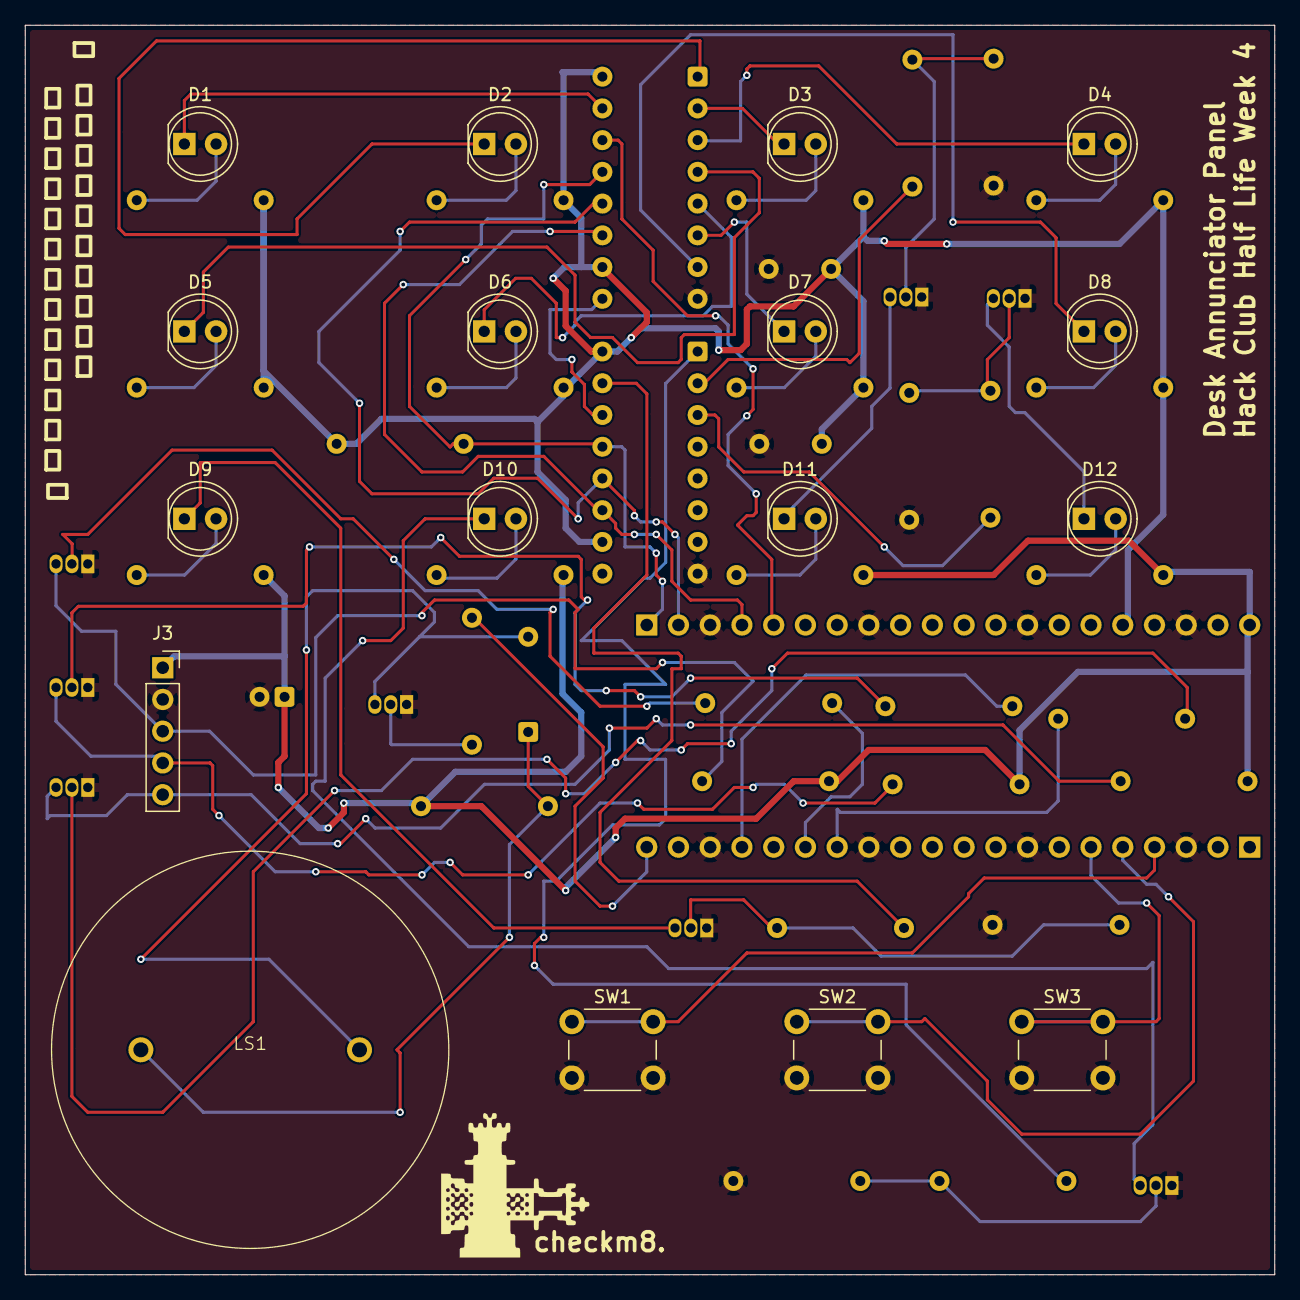
[picture p15: board annunciator.kicad_pcb from above]

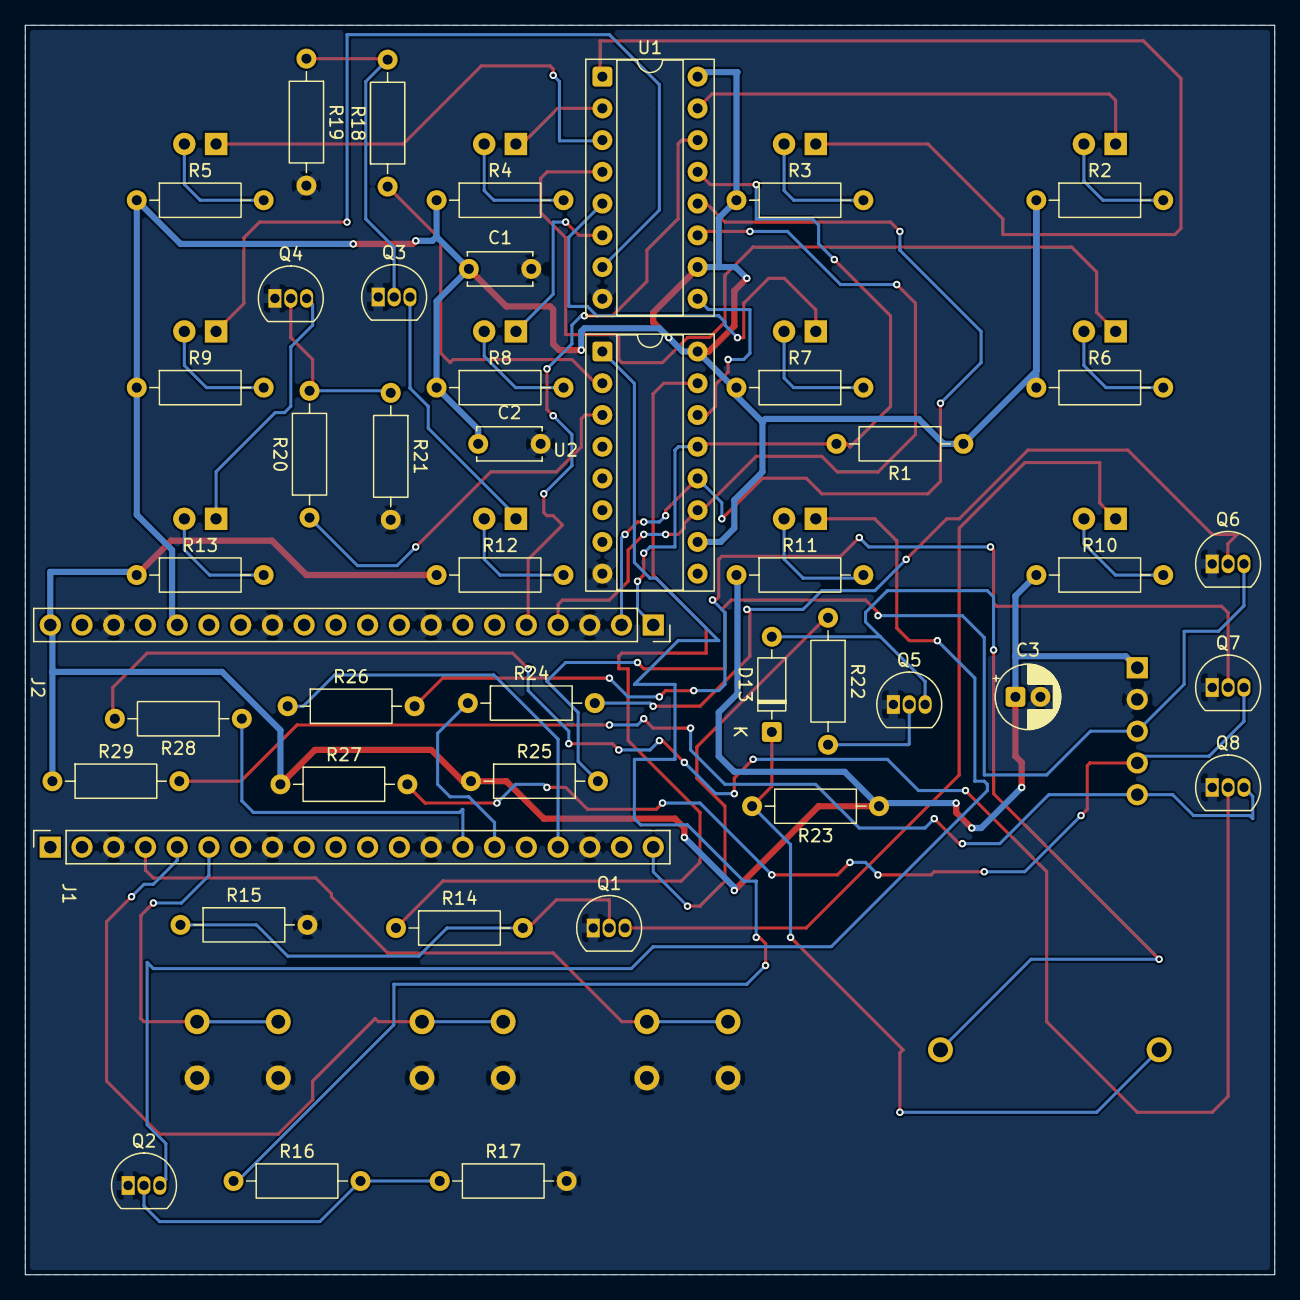
[picture p16: board annunciator.kicad_pcb from below]

Board: 2 copper layers, 100.0 x 100.0 mm, 62 parts (45 on the bottom side), 56 nets.
