atomicra1n/desk-annunciator-panel/(commit log)

2026-10-28 Finished schematic, custom footprint, assigned footprints, began PCB
    [annunciator.kicad_pcb, annunciator.kicad_sch]
2026-10-28 Sync Desk Annunciator Panel from Half Life
    [BOM.csv]
2026-10-29 Finish PCB work
    [annunciator-B_Cu.gbr, annunciator-B_Mask.gbr, annunciator-B_Silkscreen.gbr, annunciator-Edge_Cuts.gbr, annunciator-F_Cu.gbr, annunciator-F_Mask.gbr, annunciator-F_Silkscreen.gbr, annunciator-NPTH.drl]
2026-10-30 finish cad, create labels, begin firmware work
    [back_cover.stl, bezel.stl, desk-annunciator-enclosure.f3d, desk-annunciator-enclosure.step, diffusers.stl, display_support.stl, plungers.stl]
2026-10-31 fix cad files (missing diffusers)
    [desk-annunciator-enclosure.f3d, desk-annunciator-enclosure.step]
